AHWV/HBridge_HFreq_HVolt_r0/doc/conf/conf_usepackage.tex

\usepackage[
	spanish,%
	es-tabla,%
	]{babel}
\usepackage{cite} % Tidies up citation numbers.
\usepackage{url} % Provides better formatting of URLs.
\usepackage[
	utf8,
	]{inputenc} % Allows Turkish characters.
\usepackage{booktabs} % Allows the use of \toprule, \midrule and \bottomrule in tables for horizontal lines
\usepackage{graphicx}
\usepackage{booktabs}
\usepackage{siunitx}
\usepackage{cleveref}
\crefname{table}{tabla}{tablas}
\Crefname{table}{Tabla}{Tablas}
\usepackage{blindtext}
\usepackage[%
	subpreambles=true,%
	mode=buildnew,%
	sort,print,
	]{standalone}
