AHWV/HBridge_HFreq_HVolt_r0/3d/Backplane_DC.FCStd

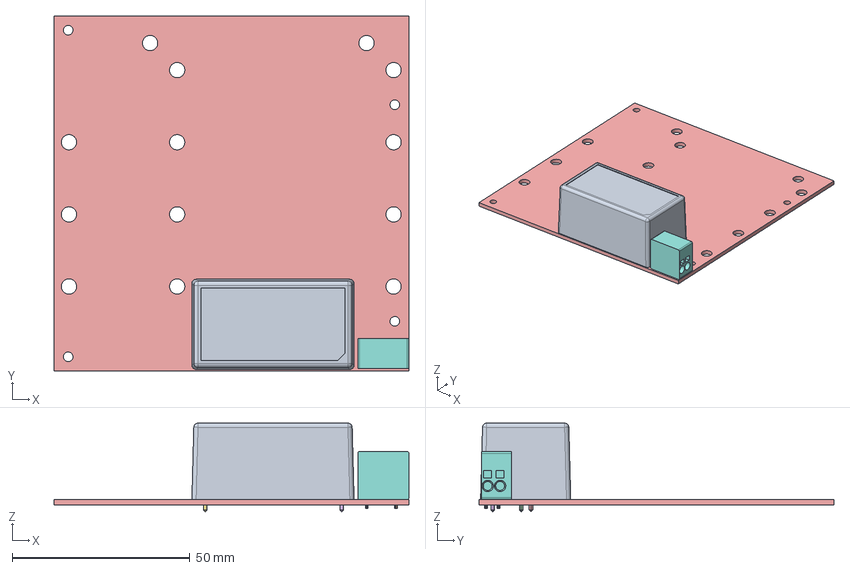
[picture p1: CAD file, 2024-12-12]
3d/Backplane_DC.FCStd
100.0 x 100.0 x 25.0 mm
MVQ-45H_____G_20130806_
U\.1
PcB
pin.2
pin.003
pin.004
pin.005
79fa9e9c-a09d-11ed-8f45-a0cec80452fd_part
79faa16c-a09d-11ed-8f45-a0cec80452fd_part
79faa16c-a09d-11ed-8f45-a0cec80452fd_part001
79faa16c-a09d-11ed-8f45-a0cec80452fd_part002
79faa16c-a09d-11ed-8f45-a0cec80452fd_part003
Pcb_587c
