AHWV/HBridge_HFreq_HVolt_r0/pcb/Backplane_DC/Backplane_DC.step

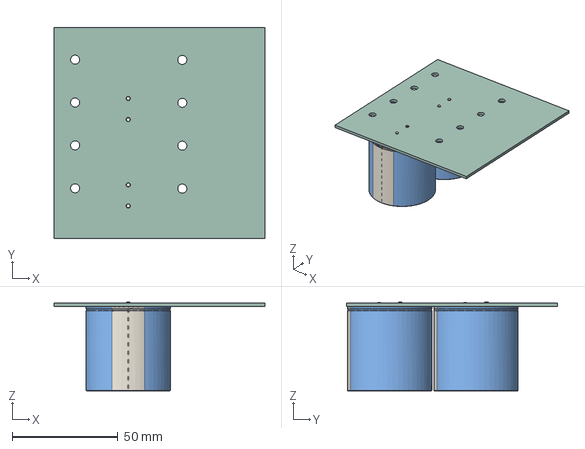
[picture p2: CAD file, 2024-11-19]
pcb/Backplane_DC/Backplane_DC.step
100.0 x 100.0 x 42.0 mm
CP_Radial_D400mm_P1000mm_SnapIn x 2
Backplane_DC_PCB
