AHWV/HBridge_HFreq_HVolt_r0/3d/Filter.FCStd

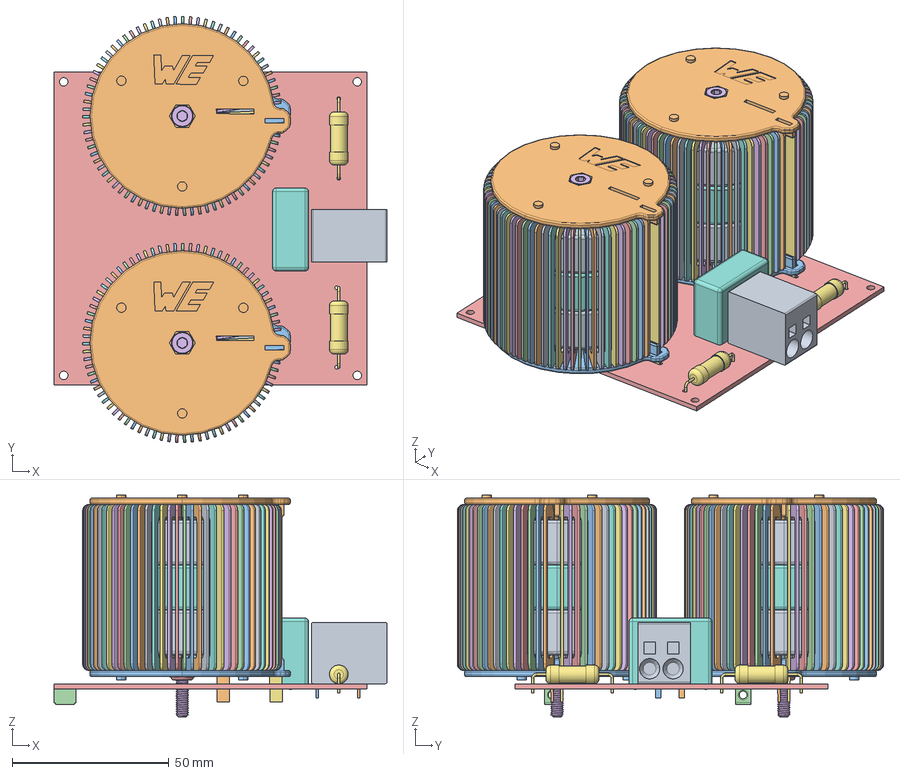
[picture p3: CAD file, 2024-12-12]
3d/Filter.FCStd
106.4 x 136.2 x 70.9 mm
76080X203 Coil and Core x 2
76080X203 Coil and Core001 x 2
76080X203 Coil and Core002 x 2
76080X203 Coil and Core003 x 2
76080X203 Coil and Core004 x 2
76080X203 Coil and Core005 x 2
76080X203 Coil and Core006 x 2
76080X203 Coil and Core007 x 2
76080X203 Coil and Core008 x 2
76080X203 Coil and Core009 x 2
76080X203 Coil and Core010 x 2
76080X203 Coil and Core011 x 2
76080X203 Coil and Core012 x 2
76080X203 Coil and Core013 x 2
76080X203 Coil and Core014 x 2
76080X203 Coil and Core015 x 2
76080X203 Coil and Core016 x 2
76080X203 Coil and Core017 x 2
76080X203 Coil and Core018 x 2
76080X203 Coil and Core019 x 2
76080X203 Coil and Core020 x 2
76080X203 Coil and Core021 x 2
76080X203 Coil and Core022 x 2
76080X203 Coil and Core023 x 2
76080X203 Coil and Core024 x 2
76080X203 Coil and Core025 x 2
76080X203 Coil and Core026 x 2
76080X203 Coil and Core027 x 2
76080X203 Coil and Core028 x 2
76080X203 Coil and Core029 x 2
76080X203 Coil and Core030 x 2
76080X203 Coil and Core031 x 2
76080X203 Coil and Core032 x 2
76080X203 Coil and Core033 x 2
76080X203 Coil and Core034 x 2
76080X203 Coil and Core035 x 2
76080X203 Coil and Core036 x 2
76080X203 Coil and Core037 x 2
76080X203 Coil and Core038 x 2
76080X203 Coil and Core039 x 2
76080X203 Coil and Core040 x 2
76080X203 Coil and Core041 x 2
76080X203 Coil and Core042 x 2
76080X203 Coil and Core043 x 2
76080X203 Coil and Core044 x 2
76080X203 Coil and Core045 x 2
76080X203 Coil and Core046 x 2
76080X203 Coil and Core047 x 2
76080X203 Coil and Core048 x 2
76080X203 Coil and Core049 x 2
76080X203 Coil and Core050 x 2
76080X203 Coil and Core051 x 2
76080X203 Coil and Core052 x 2
76080X203 Coil and Core053 x 2
76080X203 Coil and Core054 x 2
76080X203 Coil and Core055 x 2
76080X203 Coil and Core056 x 2
76080X203 Coil and Core057 x 2
76080X203 Coil and Core058 x 2
76080X203 Coil and Core059 x 2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
