AHWV/HBridge_HFreq_HVolt_r0/3d/Rectifier.FCStd

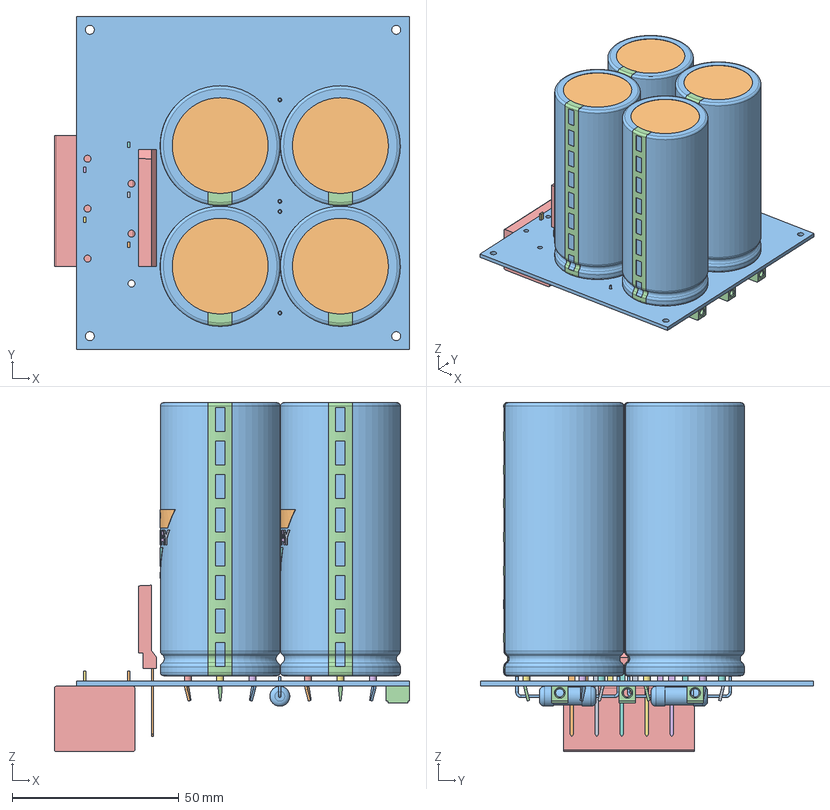
[picture p4: CAD file, 2024-12-12]
3d/Rectifier.FCStd
106.6 x 100.0 x 104.8 mm
Terminals4T x 4
Terminals4T001 x 4
Terminals4T002 x 4
Terminals4T003 x 4
PCBHoles4T x 4
PCBHoles4T001 x 4
PCBHoles4T002 x 4
PCBHoles4T003 x 4
Disc x 4
BottomInsulation x 4
Can3D x 4
InkMinusBar x 4
InkLogo x 4
InkLogo001 x 4
InkLogo002 x 4
InkLogo003 x 4
InkLogo004 x 4
InkLogo005 x 4
InkLogo006 x 4
InkLogo007 x 4
Diode_Bridge_IXYS_GUFP
Diode_Bridge_IXYS_GUFP001
Diode_Bridge_IXYS_GUFP002
Diode_Bridge_IXYS_GUFP003
Diode_Bridge_IXYS_GUFP004
Diode_Bridge_IXYS_GUFP005
R2_R_Axial_DIN0617_L170mm_D60mm_P3048mm_Horizontal_df3f5ee40b8e x 2
J3_1_837fcd1c15ac[2] x 3
b6d24482-a09d-11ed-8f45-a0cec80452fd_part
b6d2475c-a09d-11ed-8f45-a0cec80452fd_part
b6d2475c-a09d-11ed-8f45-a0cec80452fd_part001
b6d2475c-a09d-11ed-8f45-a0cec80452fd_part002
b6d2475c-a09d-11ed-8f45-a0cec80452fd_part003
b6d2475c-a09d-11ed-8f45-a0cec80452fd_part004
Pcb_47f8
