AHWV/HBridge_HFreq_HVolt_r0/3d/HalfBridge_SiC.FCStd

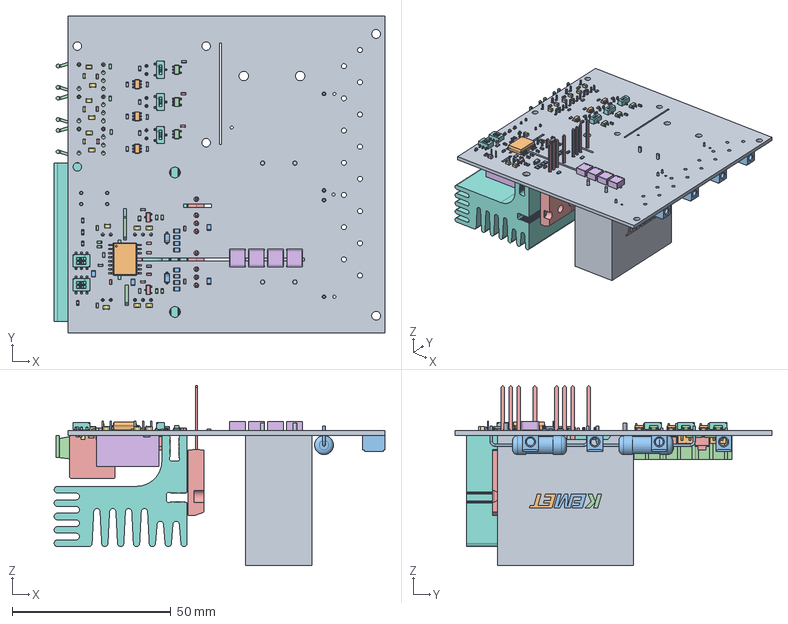
[picture p5: CAD file, 2024-12-10]
3d/HalfBridge_SiC.FCStd
104.3 x 100.0 x 56.8 mm
Pcb_ed05
U5_SOIC-16W_7.5x10.3mm_P1.27mm_noPin12_13_606f1c37d418
D6_D_SOD_123_86f777a7cf57 x 2
R9_R_0603_1608Metric_fe9d9f34c5f9 x 22
C15_C_0603_1608Metric_09ddd0478757 x 22
D3_LED_0603_1608Metric_70bb5031e2ff x 4
C38_C_0805_2012Metric_74cbd35bff10 x 18
CAS_c_12B x 3
1 pole_s x 3
U10_SOT_23_6_8cf1dc40b667 x 3
R21_R_0805_2012Metric_4eff570911b6 x 14
U3_SOT_23_5_e32904241429 x 3
U7_SOT_23_ed8fd63cd947 x 2
C5_C_2220_5750Metric_40789e461117 x 4
L5_L_0603_1608Metric_90973c27a168 x 6
CAS_c_D2B x 2
Dual_s x 2
Dual_s001 x 2
R36_R_Axial_DIN0617_L170mm_D60mm_P3048mm_Horizontal_e9082eb0809f x 2
J4_Broadcom_AFBR-16xxZ_Horizontal_9b6c4e7f7e3c x 3
79fa9e9c-a09d-11ed-8f45-a0cec80452fd_part
79faa16c-a09d-11ed-8f45-a0cec80452fd_part
79faa16c-a09d-11ed-8f45-a0cec80452fd_part001
79faa16c-a09d-11ed-8f45-a0cec80452fd_part002
79faa16c-a09d-11ed-8f45-a0cec80452fd_part003
J10_PinHeader_1x02_P254mm_Horizontal_7643f22ec726 x 3
J13_1_cfcac89c0bd5[2] x 4
R39_R_4020_10251Metric_6d765f65bd79 x 2
T1T1M-02-T-SH-L x 3
P2T1M-02-F-SH-L x 3
P22T1M-02-F-SH-L x 3
HS1_sk687_9ae714bd8fdf[2]
CFP_RB4_42X40X20_L43H41T21S37.5S110.2LL4F1.25
CFP_RB4_42X40X20_L43H41T21S37.5S110.2LL4F1.026
CFP_RB4_42X40X20_L43H41T21S37.5S110.2LL4F1.027
CFP_RB4_42X40X20_L43H41T21S37.5S110.2LL4F1.028
Q1_TO-247-4_Vertical_4070ae466a86 x 2
RKZ-xx2005D_case x 2
RKZ-xx2005D_pin1(+Vin) x 2
RKZ-xx2005D_pin7(+Vout) x 2
RKZ-xx2005D_pin5(-Vout) x 2
RKZ-xx2005D_pin6(Com) x 2
RKZ-xx2005D_pin2(-Vin) x 2
RKZ-xx2005D_potting x 2
D7_D_SMC_a35920f9d814
