AHWV/HBridge_HFreq_HVolt_r0/(list of files, cad)

Other CAD files:
3d/Assembly.FCStd
