AHWV/HBridge_HFreq_HVolt_r0/pcb/Rectifier/Rectifier.kicad_pcb

## KiCad design pcb/Rectifier/Rectifier.kicad_pcb (2024-12-12)

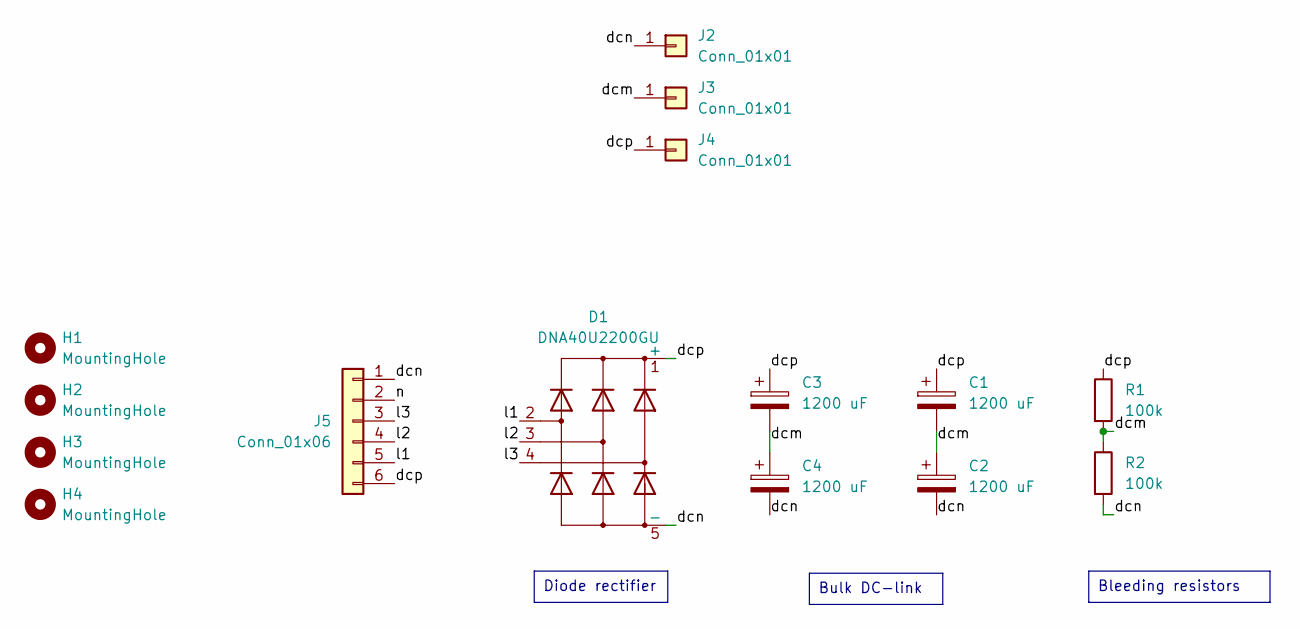
[picture p6: schematic Rectifier.kicad_sch, Diode-front-end rectifier]

Parts:
C1, C2, C3, C4: 1200 uF; CP_Radial_D35.0mm_P22.50mm_SnapIn_4Pin_TDK_B43630; Part # MAL229956122E3
D1: DNA40U2200GU; Diode_Bridge_IXYS_GUFP
H1, H2, H3, H4: MountingHole; MountingHole_2.7mm_M2.5
J2, J3, J4: Conn_01x01; WP_SMRA_7466303; Part # 7466303
J5: Conn_01x06; PhoenixContact_SPT_5_6-H-7.5-ZB_1x06_P7.5mm_Horizontal
R1, R2: 100k; R_Axial_DIN0617_L17.0mm_D6.0mm_P30.48mm_Horizontal

Connections:
/dcm: C1.2, C2.1, C3.2, C4.1, J3.1, R1.2, R2.1
/dcn: C2.2, C4.2, D1.5 (-), J2.1, J5.1, R2.2
/dcp: C1.1, C3.1, D1.1 (+), J4.1, J5.6, R1.1
/l1: D1.2, J5.5
/l2: D1.3, J5.4
/l3: D1.4, J5.3
/n: J5.2

Notes on the sheet:
Diode rectifier
Bulk DC-link
Bleeding resistors

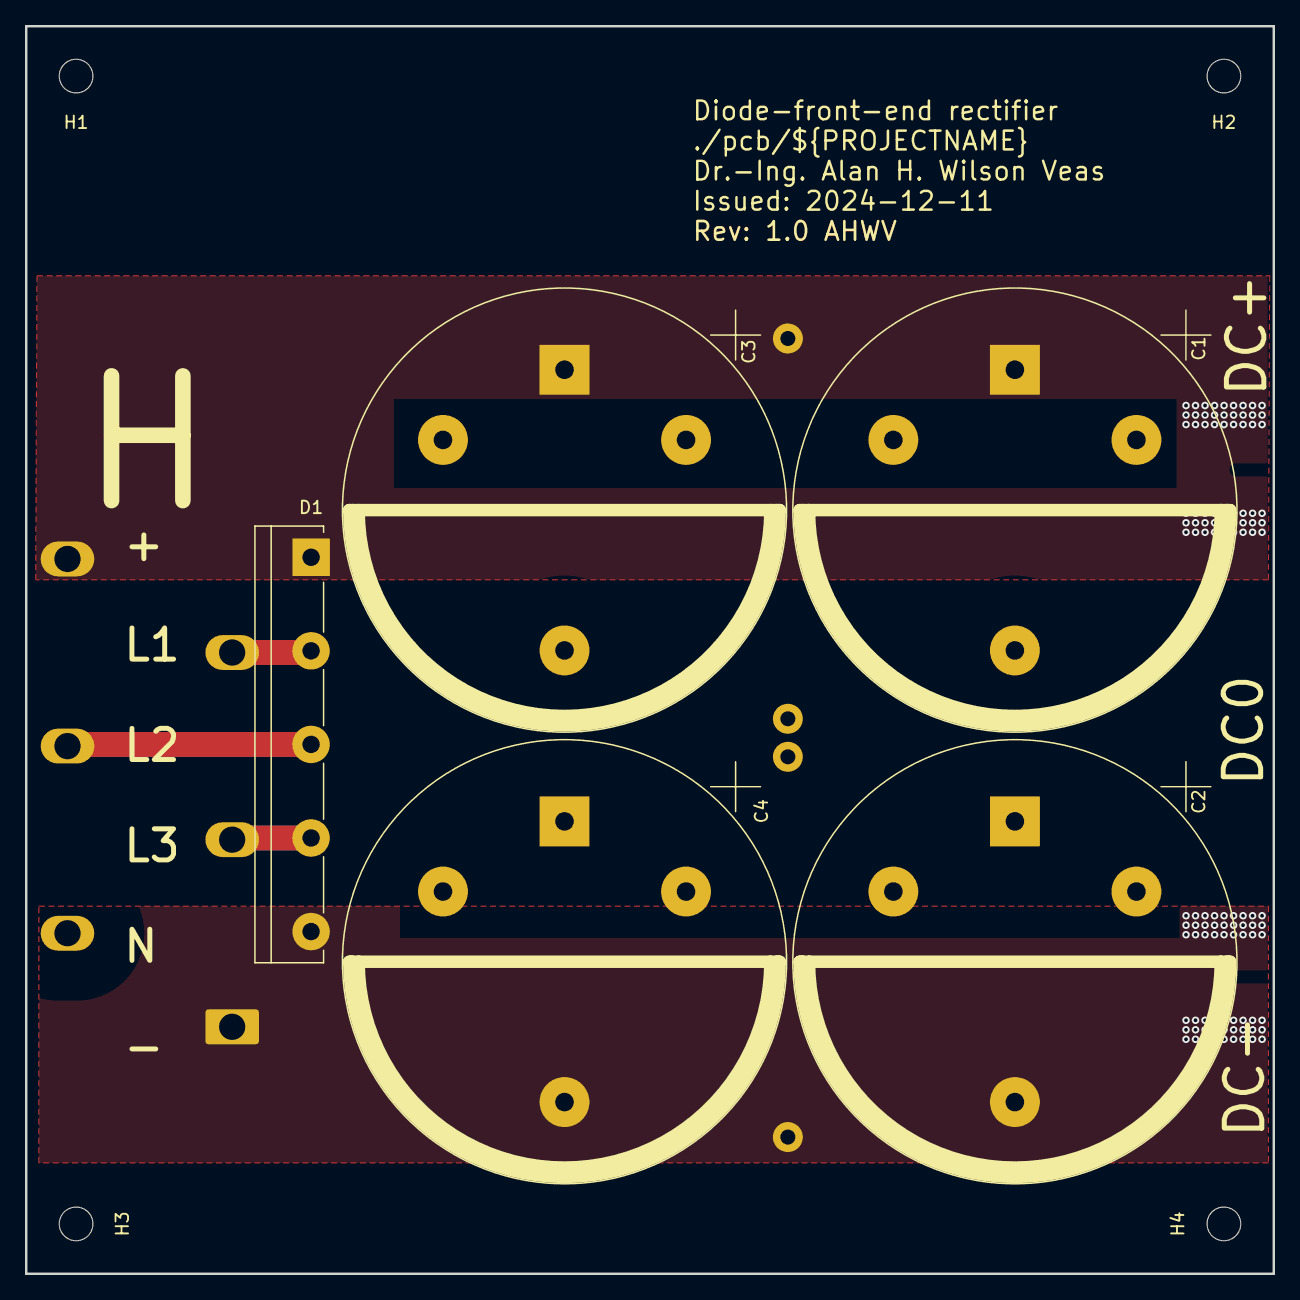
[picture p7: board Rectifier.kicad_pcb from above]

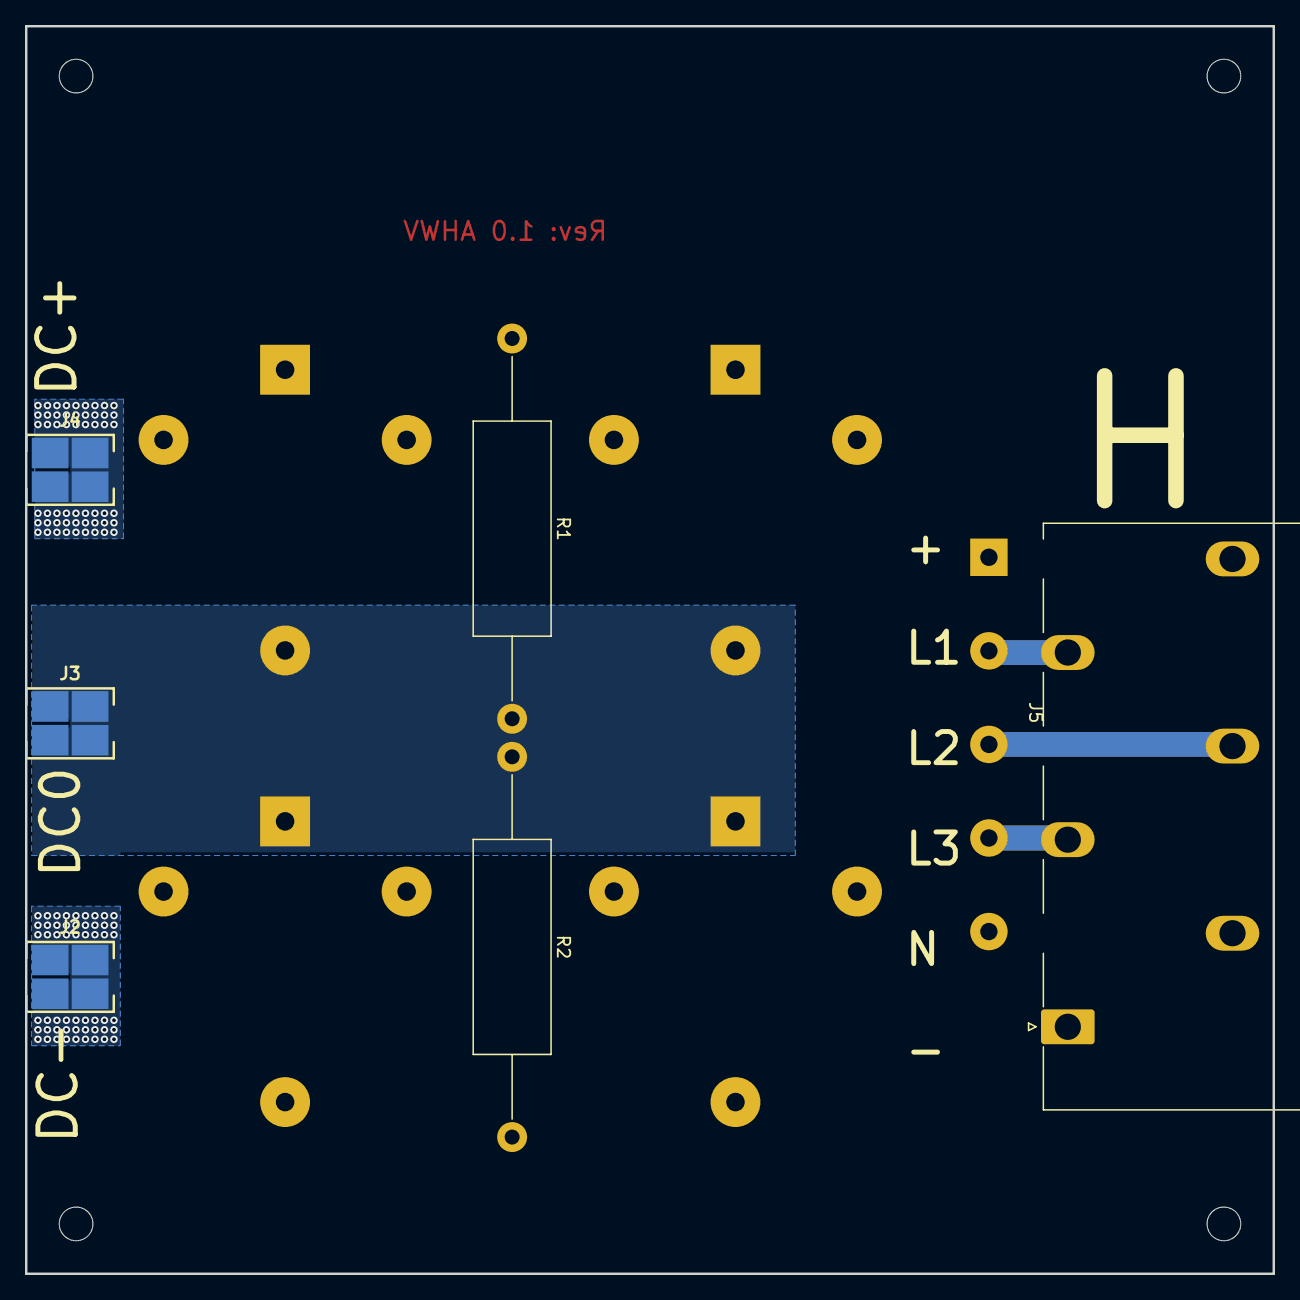
[picture p8: board Rectifier.kicad_pcb from below]

Board: 2 copper layers, 100.0 x 100.0 mm, 15 parts (6 on the bottom side), 6 nets.
