AHWV/HBridge_HFreq_HVolt_r0/pcb/Backplane_DC/Backplane_DC.kicad_pcb

## KiCad design pcb/Backplane_DC/Backplane_DC.kicad_pcb (2024-12-12)

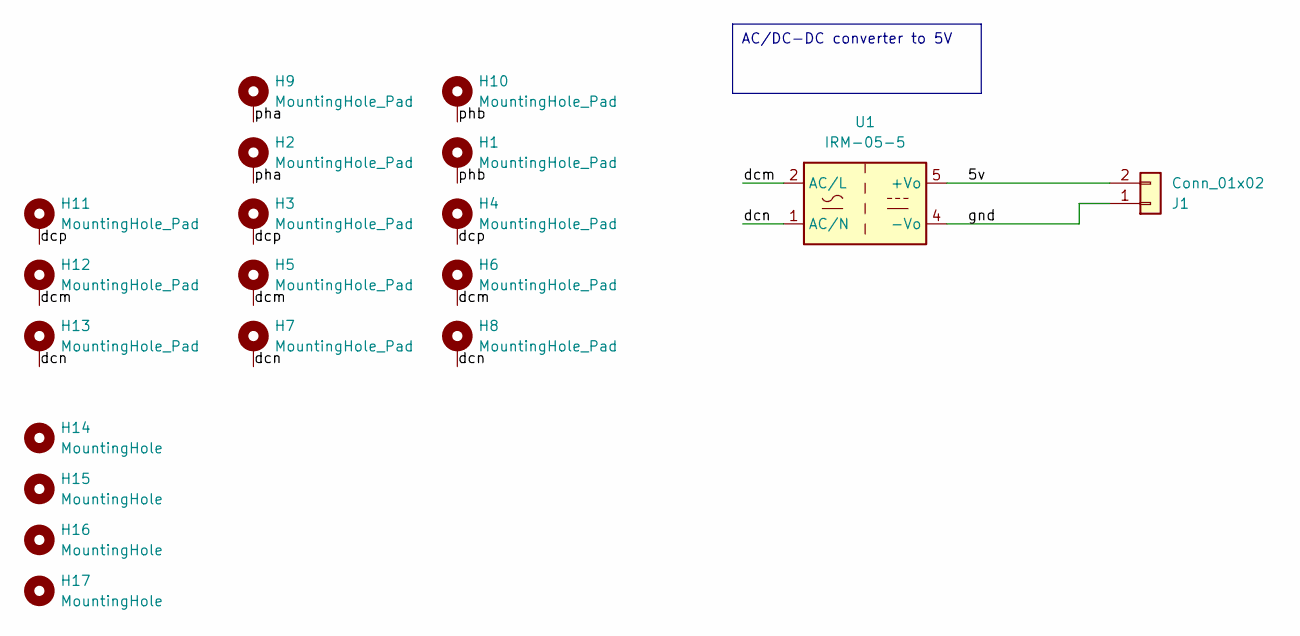
[picture p9: schematic Backplane_DC.kicad_sch, Backplane DC-link]

Parts:
H1, H2, H3, H4, H5, H6, H7, H8, H9, H10, H11, H12, H13: MountingHole_Pad; MountingHole_4.3mm_M4_DIN965_Pad
H14, H15, H16, H17: MountingHole; MountingHole_2.7mm_M2.5
J1: Conn_01x02; PhoenixContact_SPT_1.5_2-H-3.5_1x02_P3.5mm_Horizontal
U1: IRM-05-5

Connections:
/5v: J1.2, U1.5 (+Vo)
/dcm: H5.1, H6.1, H12.1, U1.2 (AC/L)
/dcn: H7.1, H8.1, H13.1, U1.1 (AC/N)
/dcp: H3.1, H4.1, H11.1
/gnd: J1.1, U1.4 (-Vo)
/pha: H2.1, H9.1
/phb: H1.1, H10.1

Notes on the sheet:
AC/DC-DC converter to 5V

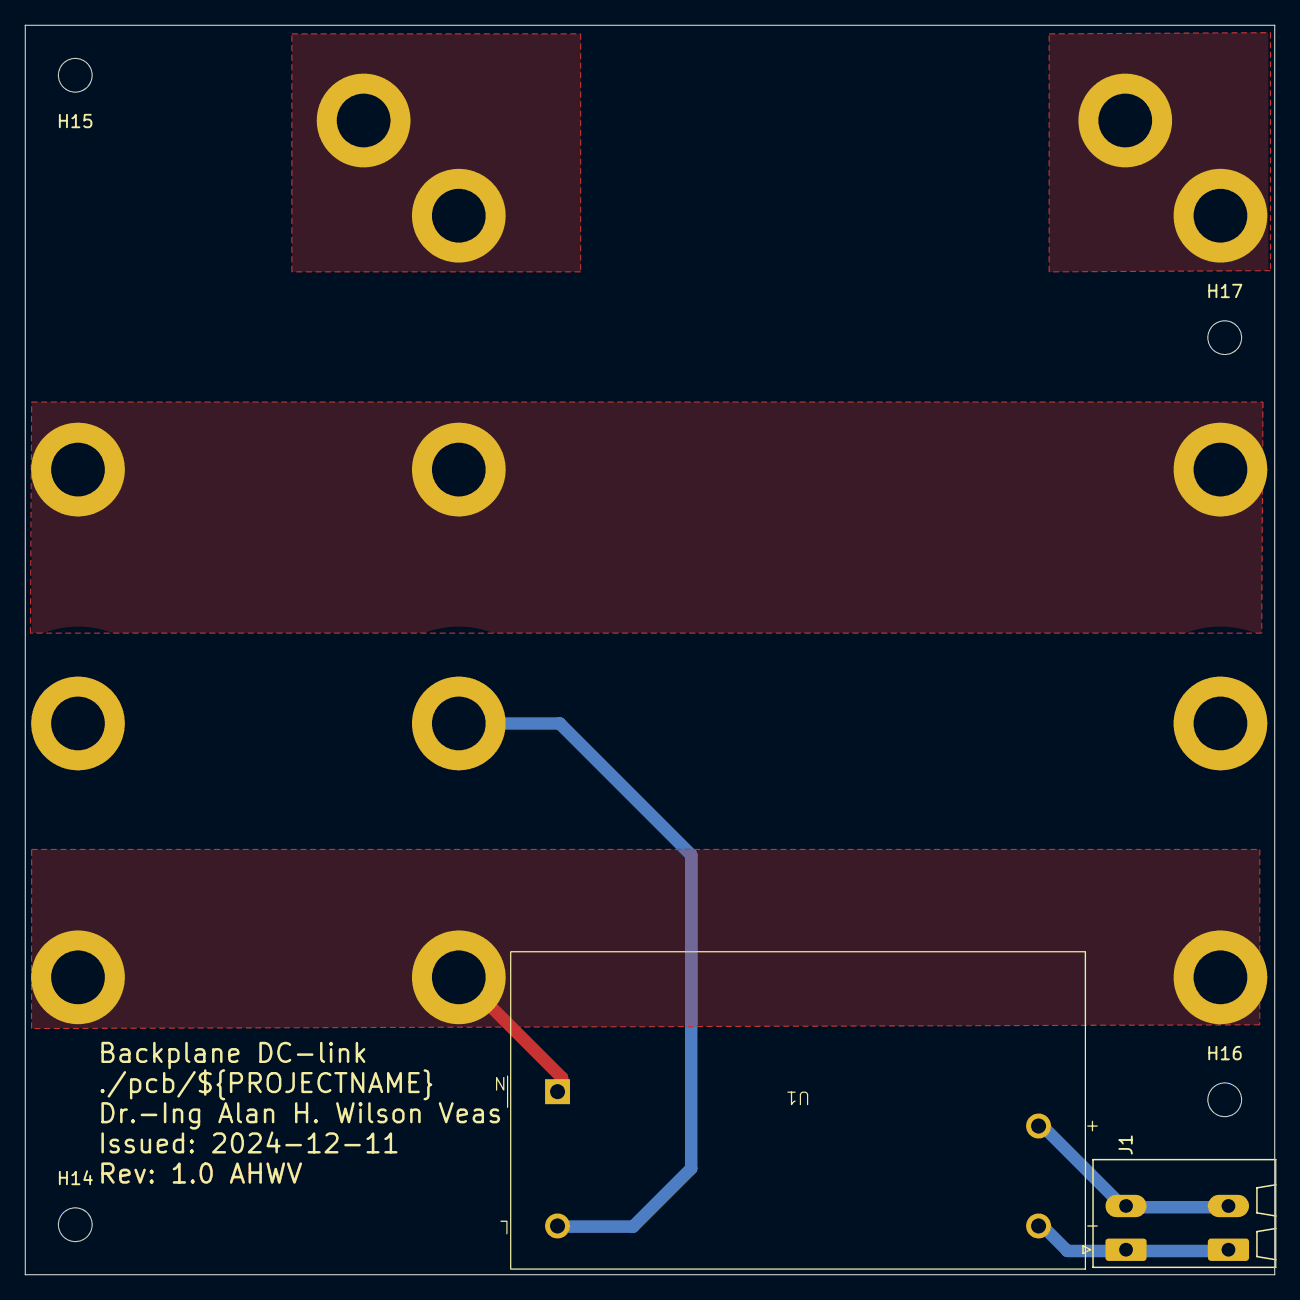
[picture p10: board Backplane_DC.kicad_pcb from above]

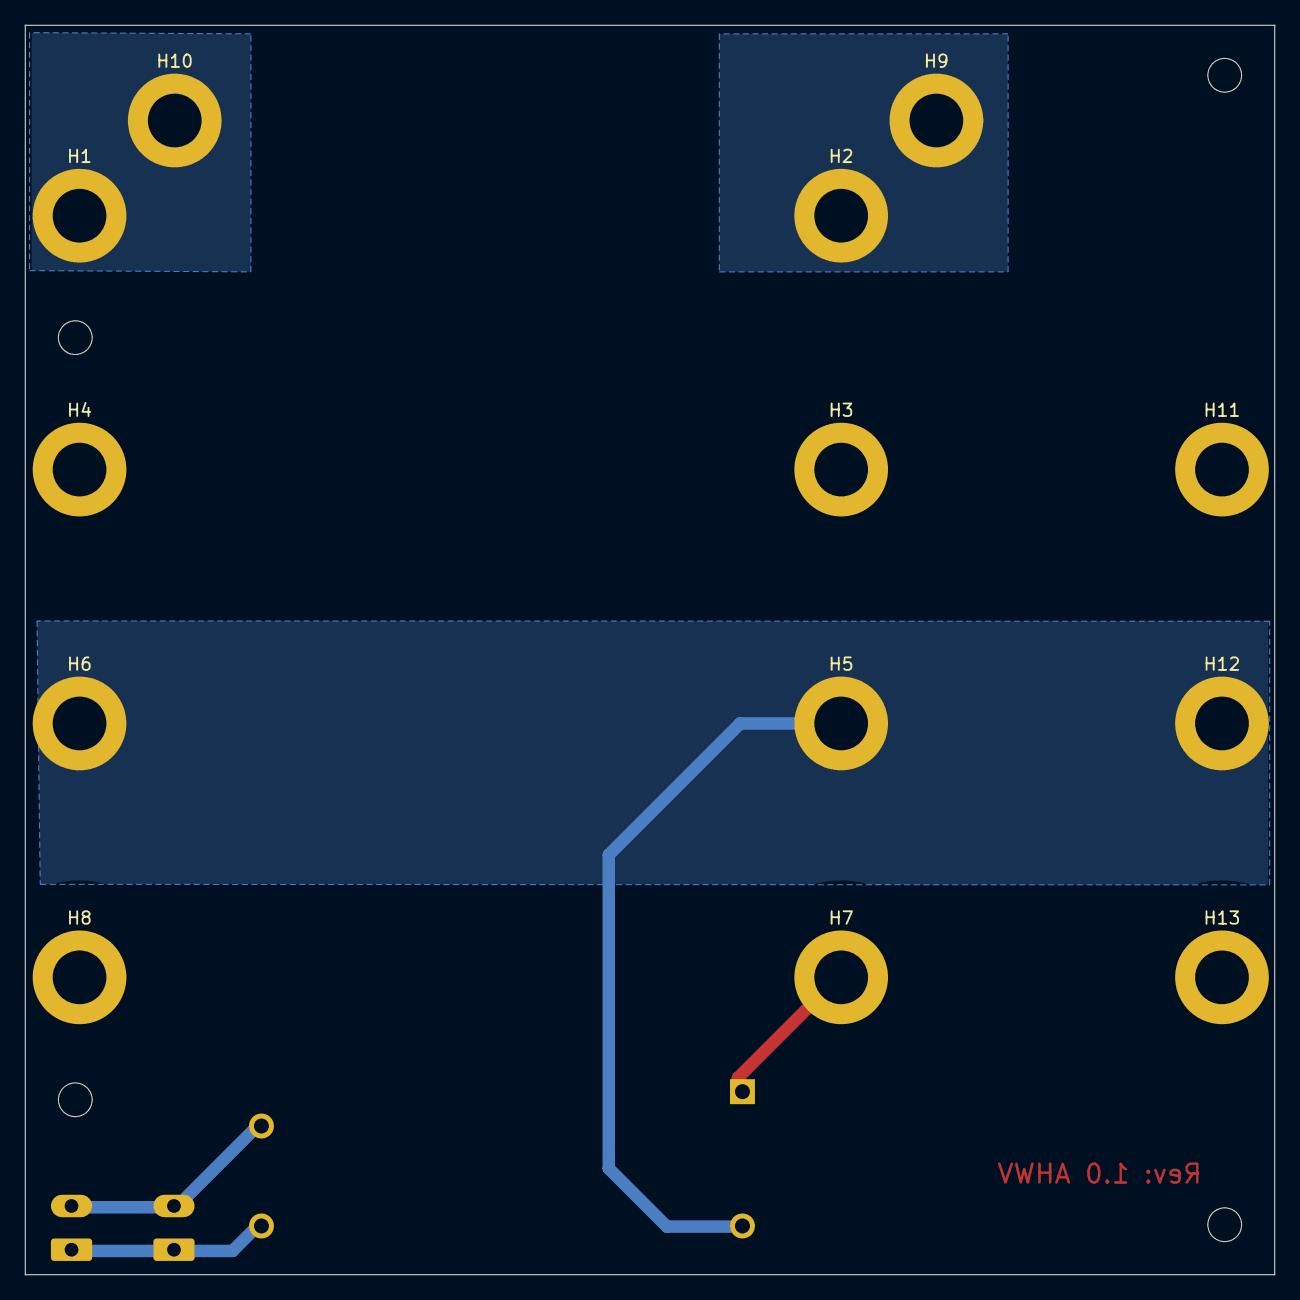
[picture p11: board Backplane_DC.kicad_pcb from below]

Board: 2 copper layers, 100.0 x 100.0 mm, 19 parts (13 on the bottom side), 7 nets.
