AHWV/HBridge_HFreq_HVolt_r0/pcb/Filter/Filter.kicad_pcb

## KiCad design pcb/Filter/Filter.kicad_pcb (2024-12-12)

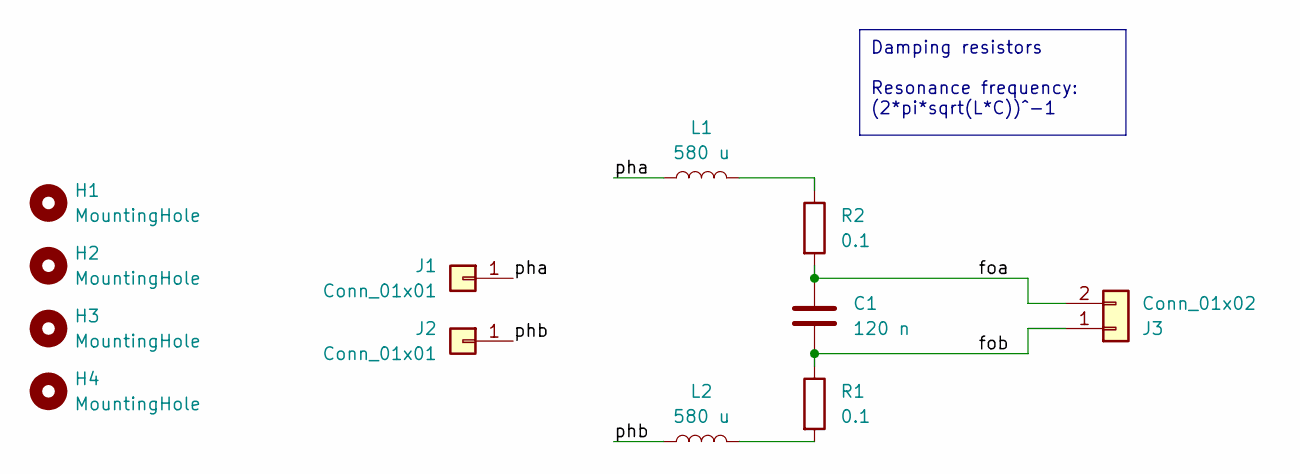
[picture p12: schematic Filter.kicad_sch, Output LC filter]

Parts:
C1: 120 n; C_Rect_L26.5mm_W11.5mm_P22.50mm_MKS4
H1, H2, H3, H4: MountingHole; MountingHole_2.7mm_M2.5
J1, J2: Conn_01x01; WP_SMRA_7466303; Part # 7466303
J3: Conn_01x02; PhoenixContact_SPT_5_2-H-7.5-ZB_1x02_P7.5mm_Horizontal
L1, L2: 580 u; L_Wuerth_WE-TORPFC_Diameter72.0mm_760801203
R1, R2: 0.1; R_Axial_DIN0617_L17.0mm_D6.0mm_P25.40mm_Horizontal

Connections:
/foa: C1.1, J3.2, R2.2
/fob: C1.2, J3.1, R1.1
/pha: J1.1, L1.1
/phb: J2.1, L2.1
unnamed: L1.2, R2.1
unnamed: L2.2, R1.2

Notes on the sheet:
Damping resistors Resonance frequency: (2*pi*sqrt(L*C))^-1

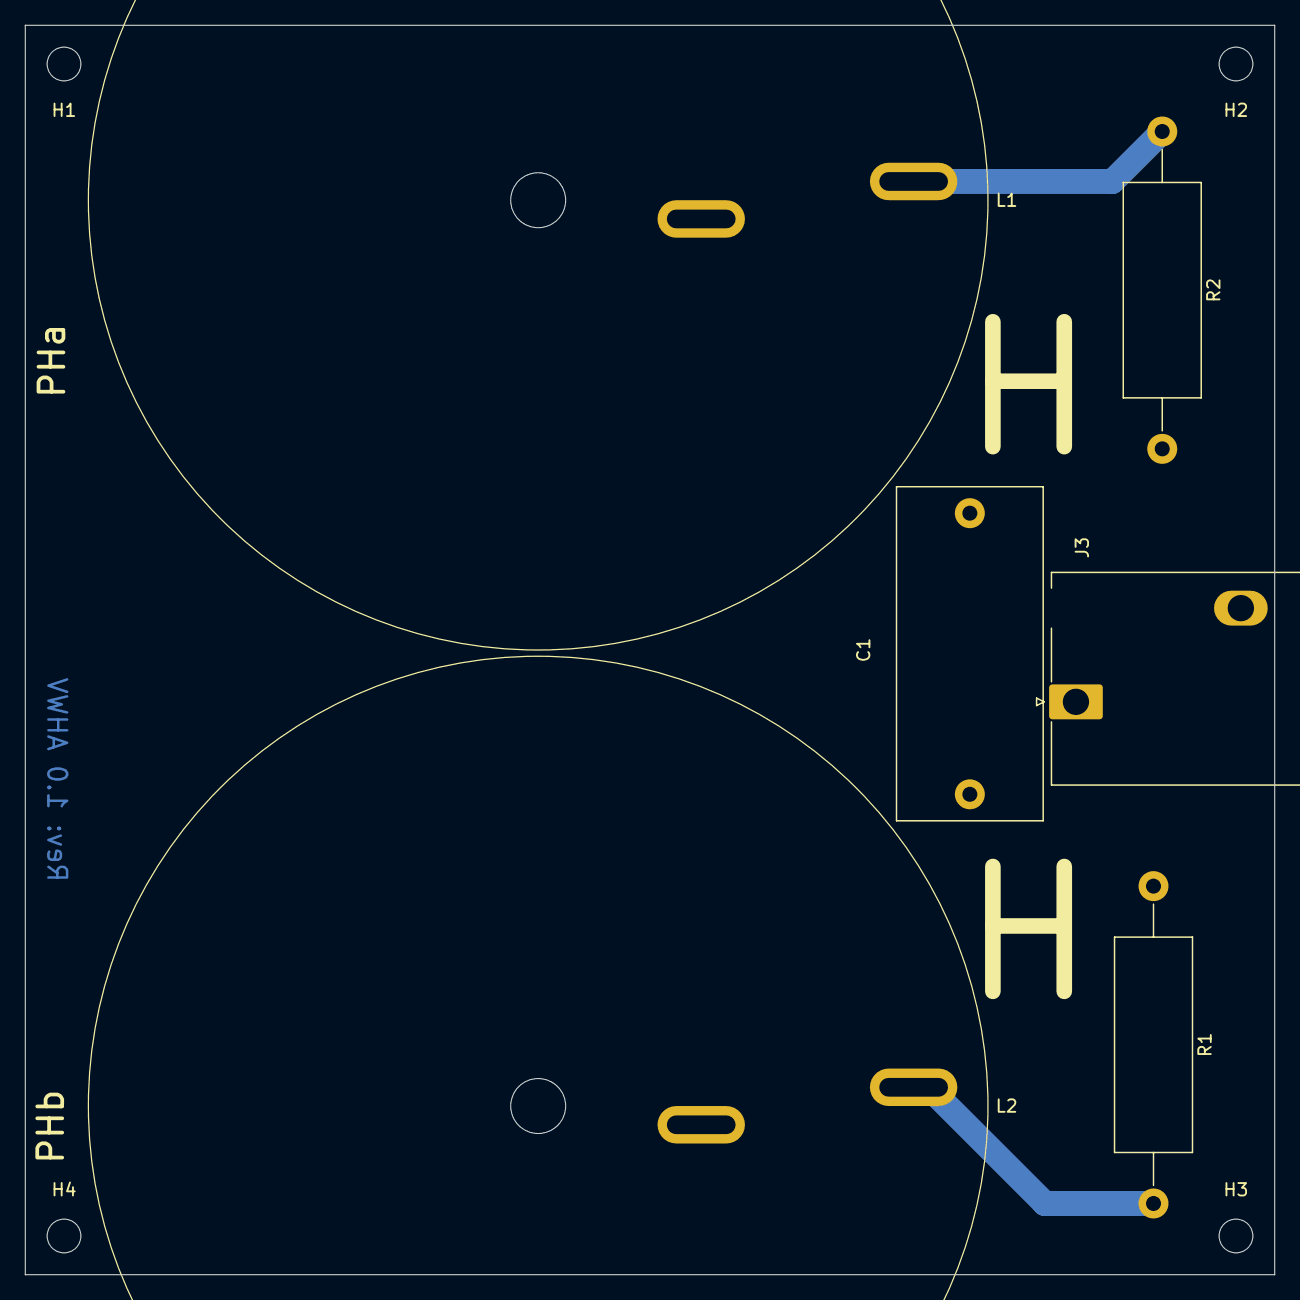
[picture p13: board Filter.kicad_pcb from above]

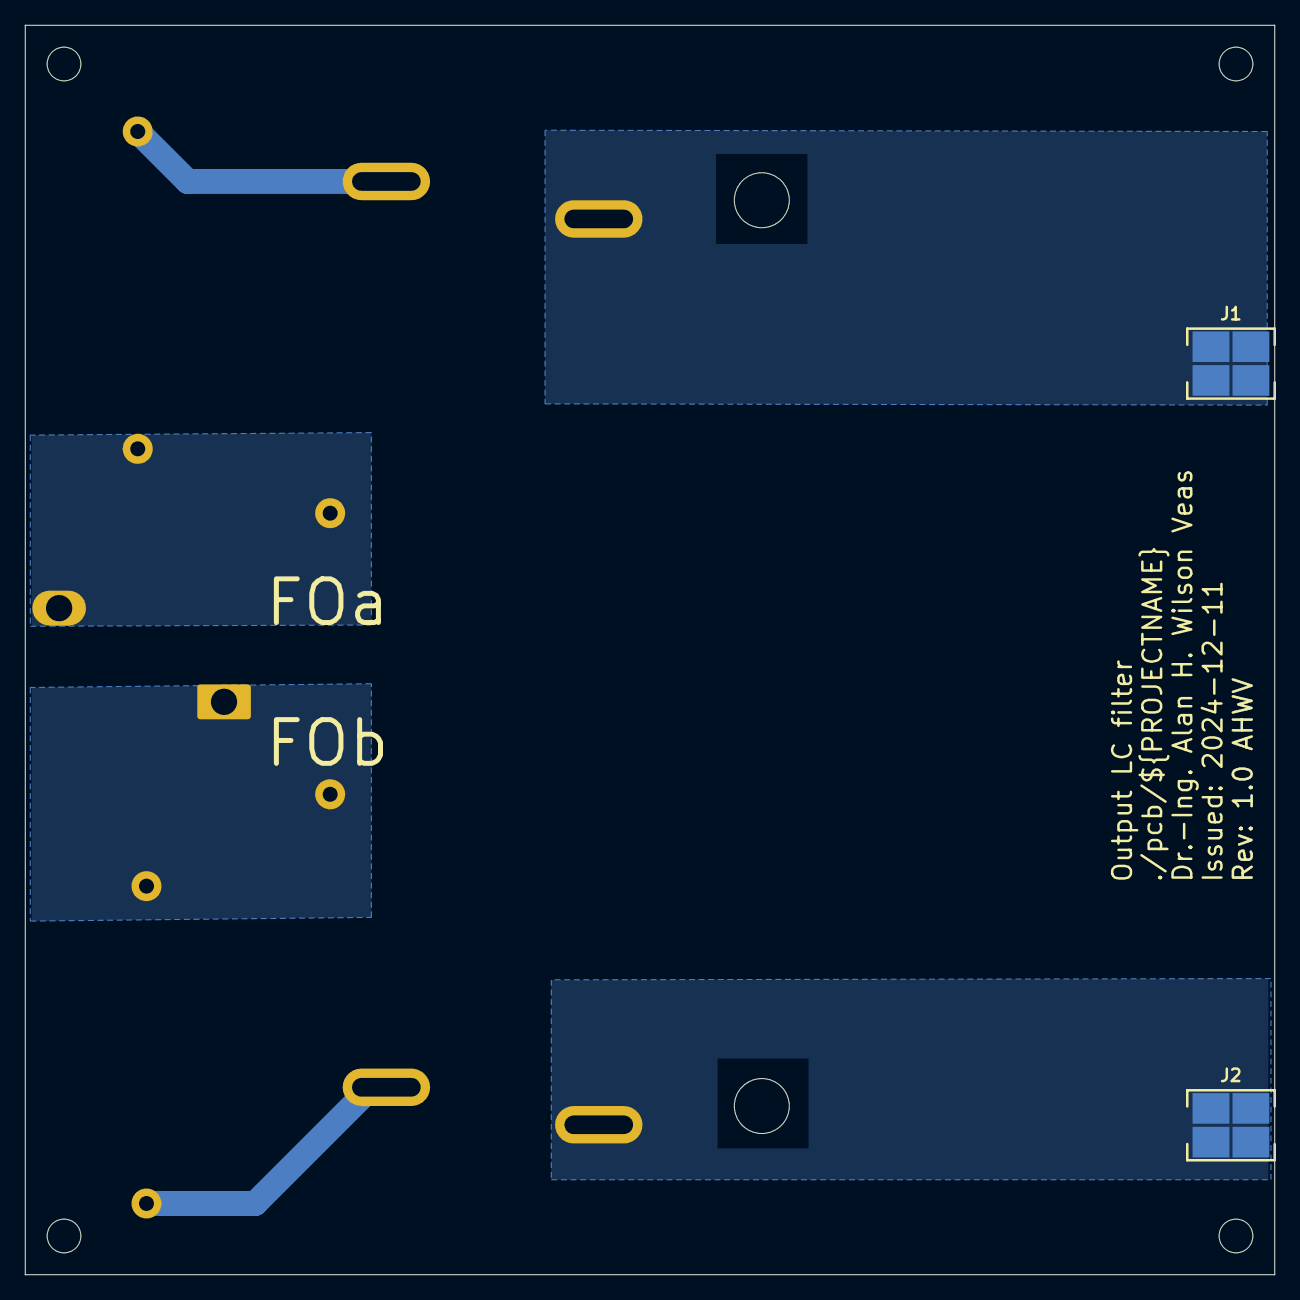
[picture p14: board Filter.kicad_pcb from below]

Board: 2 copper layers, 100.0 x 100.0 mm, 12 parts (2 on the bottom side), 6 nets.
