AHWV/HBridge_HFreq_HVolt_r0/pcb/HalfBridge_SiC/HalfBridge_SiC.kicad_pcb

## KiCad design pcb/HalfBridge_SiC/HalfBridge_SiC.kicad_pcb (2024-12-11)

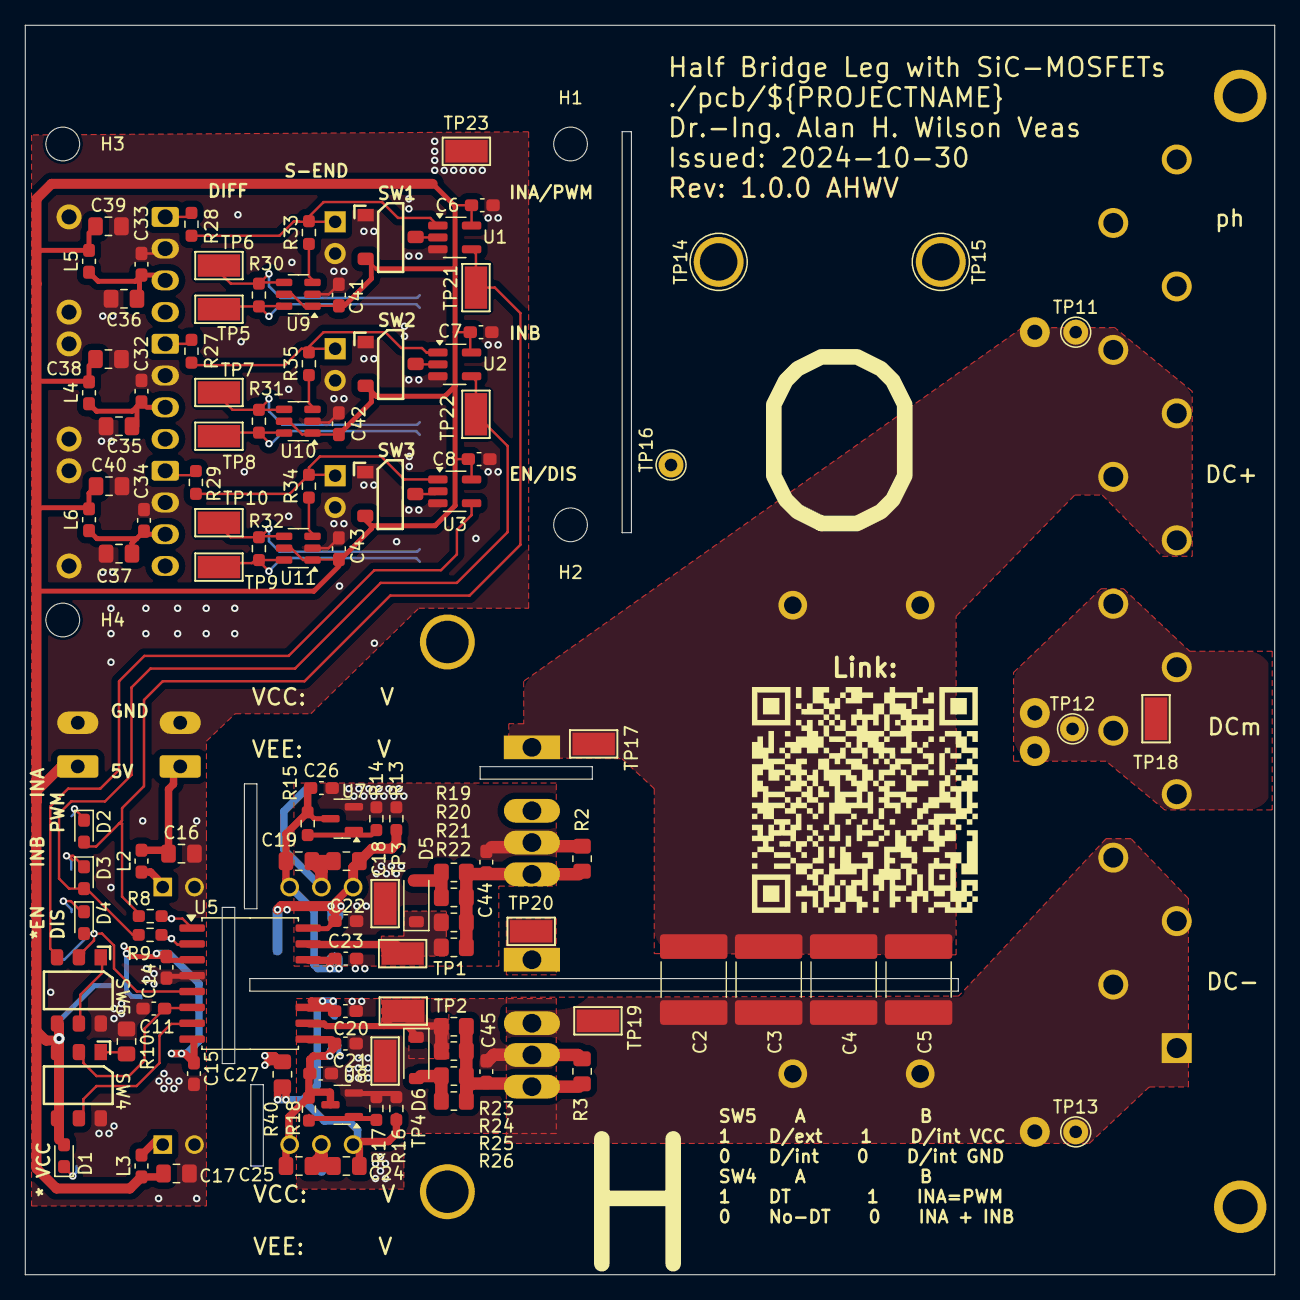
[picture p15: board HalfBridge_SiC.kicad_pcb from above]

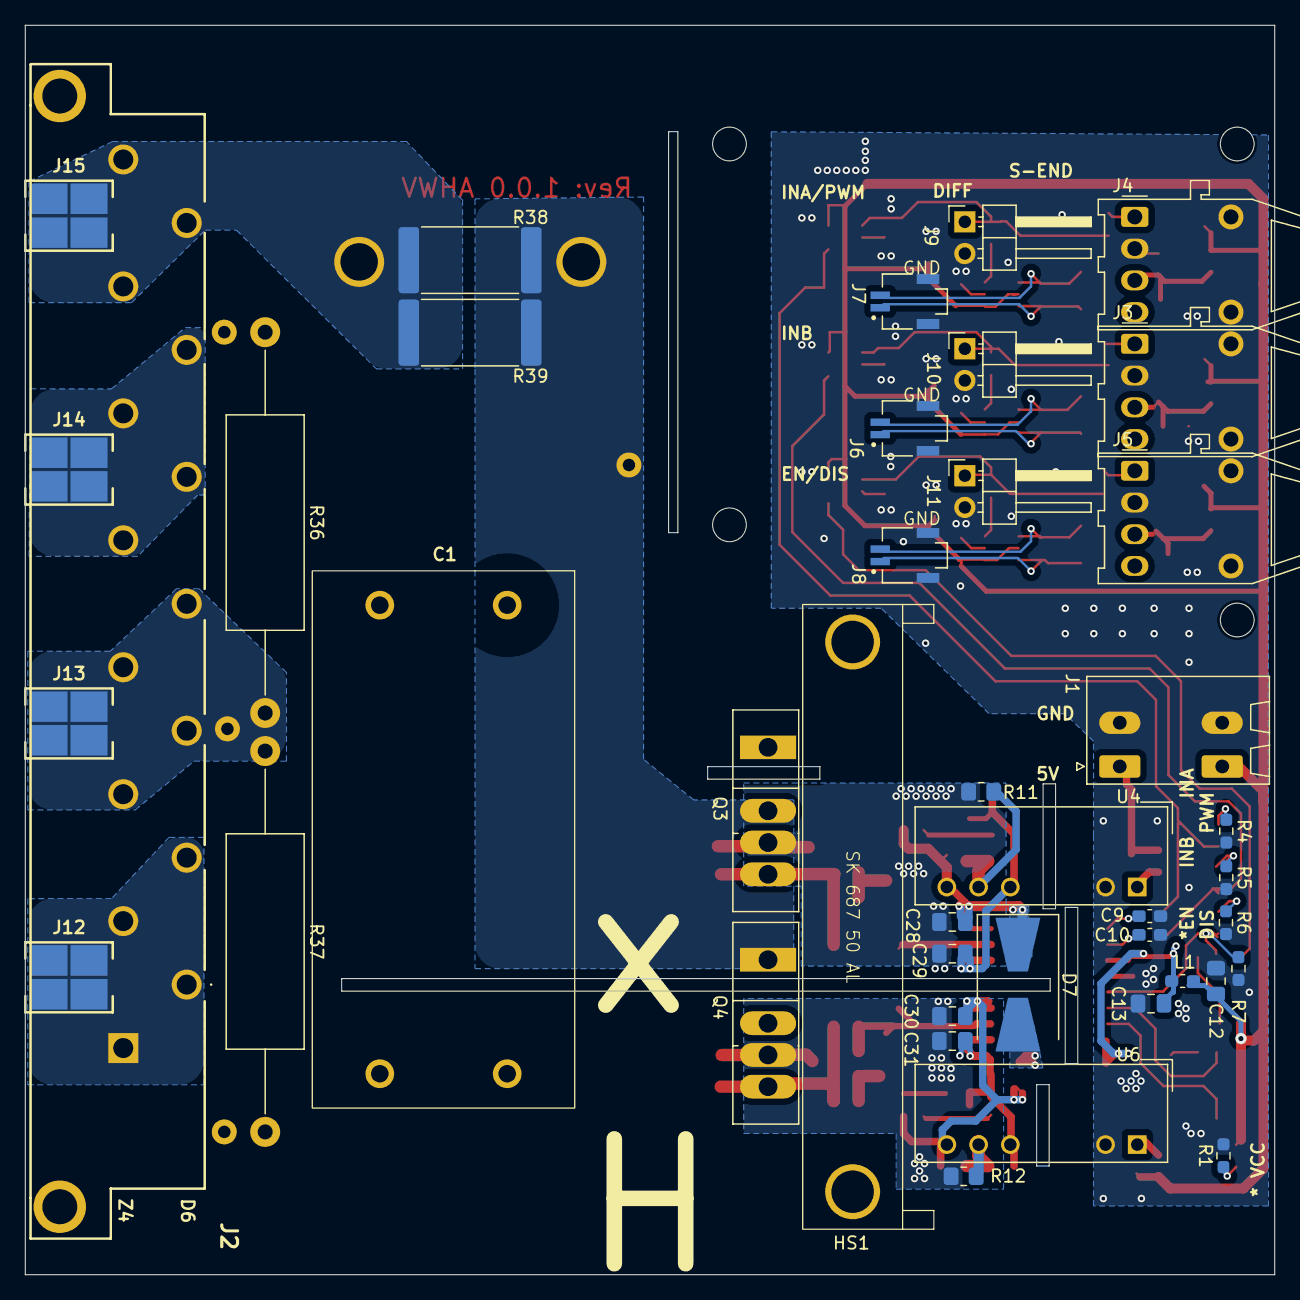
[picture p16: board HalfBridge_SiC.kicad_pcb from below]

Board: 2 copper layers, 100.0 x 100.0 mm, 160 parts (42 on the bottom side), 62 nets.

Parts:
C1: 10 u; C_Rect_L42.0mm_W20.0mm_PW37.50mm_PL10.2mm_C4AU
C2, C3, C4, C5: 100 n; C_2220_5750Metric_Pad1.97x5.40mm_HandSolder
C6, C7, C8, C11, C14, C15, C20, C21, C22, C23, C26, C27, C32, C33, C34, C41, C42, C43: 100n; C_0603_1608Metric_Pad1.08x0.95mm_HandSolder
C9, C10: 33p; C_0603_1608Metric_Pad1.08x0.95mm_HandSolder
C12, C13, C16, C17, C18, C19, C24, C25, C28, C29, C30, C31, C35, C36, C37, C38, C39, C40: 10u; C_0805_2012Metric_Pad1.18x1.45mm_HandSolder
C44, C45: 1n; C_0603_1608Metric_Pad1.08x0.95mm_HandSolder
D1, D2, D3, D4: LED; LED_0603_1608Metric_Pad1.05x0.95mm_HandSolder
D5, D6: D_Schottky; D_SOD-123
D7: D; D_SMB-SMC_Universal_Handsoldering
H1, H2, H3, H4: MountingHole; MountingHole_2.7mm_M2.5
HS1: Heatsink_Pad_2Pin; Heatsink_Fischer_SK687_50
J1: Conn_01x02; PhoenixContact_SPT_1.5_2-H-3.5_1x02_P3.5mm_Horizontal
J2: 413638-E; TEConnectivity_413638E
J3, J4, J5: AFBR-2624Z; Broadcom_AFBR-16xxZ_Horizontal
J6, J7, J8: Conn_01x02_Shielded; SAMTEC_T1M-02-F-SH-L-K
J9, J10, J11: Conn_01x02; PinHeader_1x02_P2.54mm_Horizontal
J12, J13, J14, J15: Conn_01x01; WP_SMRA_7466303
L1, L2, L3: 4.7u; L_0603_1608Metric_Pad1.05x0.95mm_HandSolder
L4, L5, L6: 1u; L_0603_1608Metric_Pad1.05x0.95mm_HandSolder
Link:: LOGO
Q3, Q4: C3M0040120K; TO-247-4_Vertical
R1, R4, R5, R6: 330; R_0603_1608Metric_Pad0.98x0.95mm_HandSolder
R2, R3: 10k; R_0805_2012Metric_Pad1.20x1.40mm_HandSolder
R7, R13, R14, R15, R16, R17, R18: R; R_0603_1608Metric_Pad0.98x0.95mm_HandSolder
R8, R9: 51; R_0603_1608Metric_Pad0.98x0.95mm_HandSolder
R10, R19, R20, R21, R22, R23, R24, R25, R26, R40: R; R_0805_2012Metric_Pad1.20x1.40mm_HandSolder
R11, R12: 0; R_0805_2012Metric_Pad1.20x1.40mm_HandSolder
R27, R28, R29, R33, R34, R35: 0; R_0603_1608Metric_Pad0.98x0.95mm_HandSolder
R30, R31, R32: 120; R_0603_1608Metric_Pad0.98x0.95mm_HandSolder
R36, R37: 100k; R_Axial_DIN0617_L17.0mm_D6.0mm_P30.48mm_Horizontal
R38, R39: 0; R_4020_10251Metric_Pad1.65x5.30mm_HandSolder
SW1, SW2, SW3: CAS-120X1; Nidec_Copal_CAS-120B1
SW4, SW5: CAS-D20X1; SW_SPDTx02_Slide_Copal_CAS-D20B1_W5.6mm_P1.7mm_GullW
TP1, TP2, TP3, TP4, TP5, TP6, TP7, TP8, TP9, TP10, TP21, TP22, TP23: TestPoint; TestPoint_Keystone_5015_Micro-Minature
TP11, TP12, TP13, TP16: TestPoint; TestPoint_THTPad_D2.0mm_Drill1.0mm
TP14, TP15: TestPoint; TestPoint_Plated_Hole_D3.0mm
TP17, TP18, TP19, TP20: TestPoint_Small; TestPoint_Keystone_5015_Micro-Minature
U1, U2, U3: 74AHC1G86; SOT-23-5_HandSoldering
U4, U6: RKD-052005D; Converter_DCDC_RECOM_RKZ-xx2005_Dual_THT_SIP7
U5: NCV51563; SOIC-16W_7.5x10.3mm_P1.27mm_NoPin_12_13
U7, U8: TL432DBZ; SOT-23
U9, U10, U11: MAX3284E; SOT-23-6

Connections:
/HalfBridge_Diff/gnd: C6.2, C7.2, C8.2, C9.2, C10.2, C11.2, C12.2, C13.2, C14.2, C15.2, C16.2, C17.2, C32.2, C33.2, C34.2, C35.2, C36.2, C37.2, C38.2, C39.2, C40.2, C41.2, C42.2, C43.2, J1.2, J3.2 (VEER), J3.5 (HP), J3.8 (HP), J4.2 (VEER), J4.5 (HP), J4.8 (HP), J5.2 (VEER), J5.5 (HP), J5.8 (HP), J6.SH (Shield), J7.SH (Shield), J8.SH (Shield), J9.2, J10.2, J11.2, R1.2, R4.2, R5.2, R6.2, R7.2, R10.1, SW1.1 (A), SW2.1 (A), SW3.1 (A), SW4.4 (A), SW5.4 (A), TP23.1, U1.3 (GND), U2.3 (GND), U3.3 (GND), U4.2 (VIN-), U5.4 (GND), U6.2 (VIN-), U9.2 (GND), U10.2 (GND), U11.2 (GND)
/HalfBridge_Diff/ina_d: J9.1, R28.1, R33.2, U1.1
/HalfBridge_Diff/ina_da: J7.1, R30.1, TP5.1, U9.6 (A)
/HalfBridge_Diff/ina_db: J7.2, R30.2, TP6.1, U9.4 (B)
/HalfBridge_Diff/ina_nd: R33.1, U9.3 (RO)
/HalfBridge_Diff/inb_d: J10.1, R27.1, R35.2, U2.1
/HalfBridge_Diff/inb_da: J6.1, R31.1, TP7.1, U10.6 (A)
/HalfBridge_Diff/inb_db: J6.2, R31.2, TP8.1, U10.4 (B)
/HalfBridge_Diff/inb_nd: R35.1, U10.3 (RO)
/HalfBridge_Diff/inen_d: J11.1, R29.1, R34.2, U3.1
/HalfBridge_Diff/inen_da: J8.1, R32.1, TP9.1, U11.6 (A)
/HalfBridge_Diff/inen_db: J8.2, R32.2, TP10.1, U11.4 (B)
/HalfBridge_Diff/inen_nd: R34.1, U11.3 (RO)
/HalfBridge_Diff/vcc: C6.1, C7.1, C8.1, C12.1, C16.1, C17.1, C38.1, C39.1, C40.1, C41.1, C42.1, C43.1, D1.2 (A), J1.1, L1.1, L2.1, L3.1, L4.2, L5.2, L6.2, SW1.3 (C), SW2.3 (C), SW3.3 (C), SW4.3 (C), SW4.6 (C), SW5.6 (C), U1.5 (VCC), U2.5 (VCC), U3.5 (VCC), U9.1 (VCC), U9.5 (VL), U10.1 (VCC), U10.5 (VL), U11.1 (VCC), U11.5 (VL)
/HalfBridge_GateDriver/adjh: R14.1, R15.2, U7.1 (REF)
/HalfBridge_GateDriver/adjl: R17.1, R18.2, U8.1 (REF)
/HalfBridge_GateDriver/anb: SW4.5 (B), U5.7 (ANB)
/HalfBridge_GateDriver/asgh: D5.2 (A), R19.1, R20.1
/HalfBridge_GateDriver/asgl: D6.2 (A), R25.1, R26.1
/HalfBridge_GateDriver/bootR: D7.2 (A), R40.1
/HalfBridge_GateDriver/comh: C18.2, C19.1, R11.1, U4.6 (COM)
/HalfBridge_GateDriver/coml: C24.2, C25.1, R12.1, U6.6 (COM)
/HalfBridge_GateDriver/dis: D4.2 (A), R7.1, SW5.2 (B), U5.5 (DIS)
/HalfBridge_GateDriver/dis_i: SW5.1 (A), SW5.5 (B)
/HalfBridge_GateDriver/dis_x: SW5.3 (C), U3.4
/HalfBridge_GateDriver/dt: C11.1, SW4.2 (B), U5.6 (DT)
/HalfBridge_GateDriver/gonh: D5.1 (K), R21.1, R22.1, TP1.1, U5.15 (OUTA)
/HalfBridge_GateDriver/gonl: D6.1 (K), R23.1, R24.1, TP2.1, U5.10 (OUTB)
/HalfBridge_GateDriver/inaf: C9.1, R8.2, U5.1 (INA)
/HalfBridge_GateDriver/inbf: C10.1, R9.2, U5.2 (INB)
/HalfBridge_GateDriver/inga: D2.2 (A), R8.1, TP21.1, U1.4
/HalfBridge_GateDriver/ingb: D3.2 (A), R9.1, TP22.1, U2.4
/HalfBridge_GateDriver/kh: C22.2, C23.1, C26.1, C28.2, C29.1, C44.2, Q3.3 (DS), R2.2, R11.2, R13.1, R14.2, TP3.1, U7.2 (K)
/HalfBridge_GateDriver/kl: C20.2, C21.1, C27.1, C30.2, C31.1, C45.2, Q4.3 (DS), R3.2, R12.2, R16.1, R17.2, TP4.1, U8.2 (K)
/HalfBridge_GateDriver/lrdis: D4.1 (K), R6.1
/HalfBridge_GateDriver/lringa: D2.1 (K), R4.1
/HalfBridge_GateDriver/lringb: D3.1 (K), R5.1
/HalfBridge_GateDriver/rdt: R10.2, SW4.1 (A)
/HalfBridge_GateDriver/vcci: C13.1, C14.1, C15.1, L1.2, U5.3 (VCCI), U5.8 (VCCI)
/HalfBridge_GateDriver/vddh: C18.1, C22.1, C28.1, D7.1 (K), R13.2, U4.7 (+VDC), U5.16 (VDDA)
/HalfBridge_GateDriver/vddl: C20.1, C24.1, C30.1, R16.2, R40.2, U5.11 (VDDB), U6.7 (+VDC)
/HalfBridge_GateDriver/vindc+h: L2.2, U4.1 (VIN+)
/HalfBridge_GateDriver/vindc+l: L3.2, U6.1 (VIN+)
/HalfBridge_GateDriver/vssh: C19.2, C23.2, C26.2, C29.2, R15.1, U4.5 (-VDC), U5.14 (VSSA), U7.3 (A)
/HalfBridge_GateDriver/vssl: C21.2, C25.2, C27.2, C31.2, R18.1, U5.9 (VSSB), U6.5 (-VDC), U8.3 (A)
/HalfBridge_GateDriver/xorina: SW1.2 (B), U1.2
/HalfBridge_GateDriver/xorinb: SW2.2 (B), U2.2
/HalfBridge_GateDriver/xorinen: SW3.2 (B), U3.2
/HalfBridge_Optical/oina: J4.1 (Data_Out), R28.2
/HalfBridge_Optical/oinb: J3.1 (Data_Out), R27.2
/HalfBridge_Optical/oinen: J5.1 (Data_Out), R29.2
/HalfBridge_Optical/vcca: C33.1, C36.1, J4.3 (VCCR), L5.1
/HalfBridge_Optical/vccb: C32.1, C35.1, J3.3 (VCCR), L4.1
/HalfBridge_Optical/vccen: C34.1, C37.1, J5.3 (VCCR), L6.1
/HalfBridge_Power/gh: C44.1, Q3.4 (G), R2.1, R19.2, R20.2, R21.2, R22.2
/HalfBridge_Power/gl: C45.1, Q4.4 (G), R3.1, R23.2, R24.2, R25.2, R26.2
/dcm: J2.D14, J2.D18, J2.Z12, J2.Z16, J13.1, R36.2, R37.1, TP12.1, TP18.1
/dcn: C1.2, C2.2, C3.2, C4.2, C5.2, J2.D6, J2.D10, J2.Z4, J2.Z8, J12.1, Q4.2 (S), R37.2, TP13.1, TP19.1
/dcp: C1.1, C2.1, C3.1, C4.1, C5.1, J2.D22, J2.D26, J2.Z20, J2.Z24, J14.1, Q3.1 (D), R36.1, TP11.1, TP17.1
/lvcc: D1.1 (K), R1.1
/ph: Q3.2 (S), Q4.1 (D), R38.1, R39.1, TP14.1, TP16.1, TP20.1
/pho: J2.D30, J2.Z28, J2.Z32, J15.1, R38.2, R39.2, TP15.1
