AHWV/HBridge_HFreq_HVolt_r0/(commit log)

2024-10-28 pcb + horizontal of
    [HalfBridge_Optical.kicad_sch, HalfBridge_SiC.kicad_pcb, HalfBridge_SiC.kicad_sch]
2024-10-30 vgatereg + route + hsink
    [HalfBridge_Diff.kicad_sch, HalfBridge_GateDriver.kicad_sch, HalfBridge_Optical.kicad_sch, HalfBridge_Power.kicad_sch, HalfBridge_SiC.kicad_pcb, HalfBridge_SiC.kicad_sch, HalfBridge_SiC.step, SK 687 50 SK.stp]
2024-10-30 comment + gdriver + logo
    [HalfBridge_Diff.kicad_sch, HalfBridge_GateDriver.kicad_sch, HalfBridge_Optical.kicad_sch, HalfBridge_Power.kicad_sch, HalfBridge_SiC.kicad_pcb, HalfBridge_SiC.kicad_sch]
2024-10-30 2DPDT switch footprint
    [CAS-D20B1.stp, HalfBridge_GateDriver.kicad_sch, HalfBridge_SiC.kicad_pcb]
2024-11-04 vcc label
    [HalfBridge_SiC.kicad_pcb]
2024-11-05 part number
    [HalfBridge_Power.kicad_sch, HalfBridge_SiC.kicad_pcb, HalfBridge_SiC.kicad_sch]
2024-11-12 local lib
    [7466303.stp, CAS-120A1.stp, HalfBridge_Diff.kicad_sch, HalfBridge_GateDriver.kicad_sch, HalfBridge_InMeasurement.kicad_sch, HalfBridge_Optical.kicad_sch, HalfBridge_Power.kicad_sch, HalfBridge_SiC.kicad_pcb]
2024-11-13 pcb + newlib
    [HalfBridge_Diff.kicad_sch, HalfBridge_GateDriver.kicad_sch, HalfBridge_InMeasurement.kicad_sch, HalfBridge_Optical.kicad_sch, HalfBridge_Power.kicad_sch, HalfBridge_SiC.kicad_pcb]
2024-11-13 no step file
    [HalfBridge_SiC.step]
2024-11-19 backplane + external lib
    [74663025.stp, 7466303.stp, 7762-SEMS.step, AMT0440051DB0000G.stp, Backplane_DC.kicad_pcb, Backplane_DC.kicad_sch, Backplane_DC.step, C4AQNBU4550M1EJ.stp]
2024-12-03 update lib
    [Backplane_DC.kicad_pcb, Backplane_DC.kicad_sch, HalfBridge_Diff.kicad_sch, HalfBridge_GateDriver.kicad_sch, HalfBridge_InMeasurement.kicad_sch, HalfBridge_Optical.kicad_sch, HalfBridge_Power.kicad_sch, HalfBridge_SiC.kicad_pcb]
2024-12-10 filter + sim + assembly3d
    [Assembly.FCStd, Backplane_DC.FCStd, Backplane_DC.kicad_pcb, Backplane_DC.kicad_sch, Filter.FCStd, Filter.kicad_pcb, Filter.kicad_sch, HalfBridge_GateDriver.kicad_sch]
2024-12-10 filter + backplane
    [Assembly.FCStd, Backplane_DC.FCStd, Backplane_DC.kicad_pcb, Filter.FCStd, Filter.kicad_pcb]
2024-12-11 designator + part n°
    [Backplane_DC.kicad_sch, HalfBridge_Diff.kicad_sch, HalfBridge_GateDriver.kicad_sch, HalfBridge_InMeasurement.kicad_sch, HalfBridge_Optical.kicad_sch, HalfBridge_Power.kicad_sch, HalfBridge_SiC.kicad_pcb, HalfBridge_SiC.kicad_sch]
2024-12-11 new 3d filter
    [Assembly.FCStd, Filter.FCStd, Filter.kicad_pcb]
